ksya/ILIFERobot/images/IMG_20171003_143027.jpg

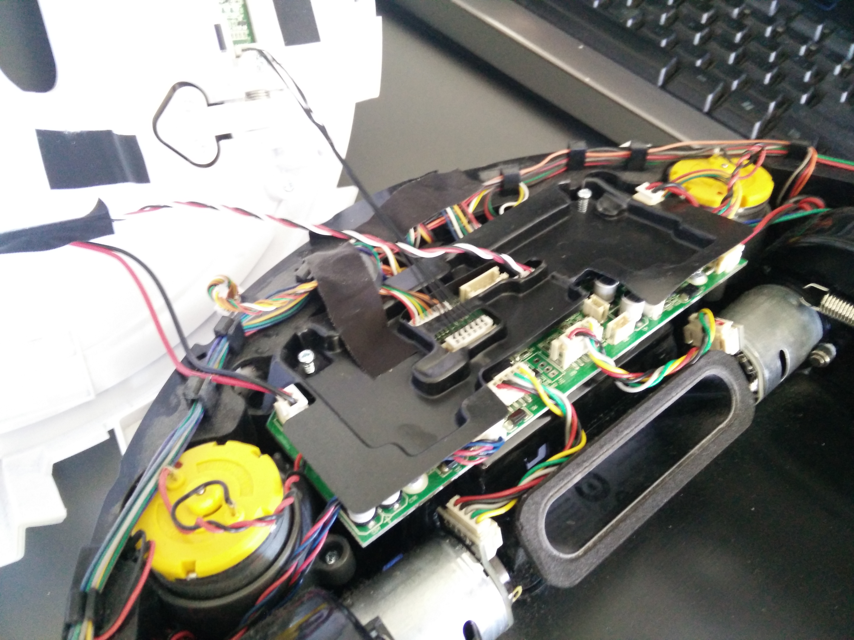
images/IMG_20171003_143027.jpg
