ksya/ILIFERobot/images/IMG_20171003_145452.jpg

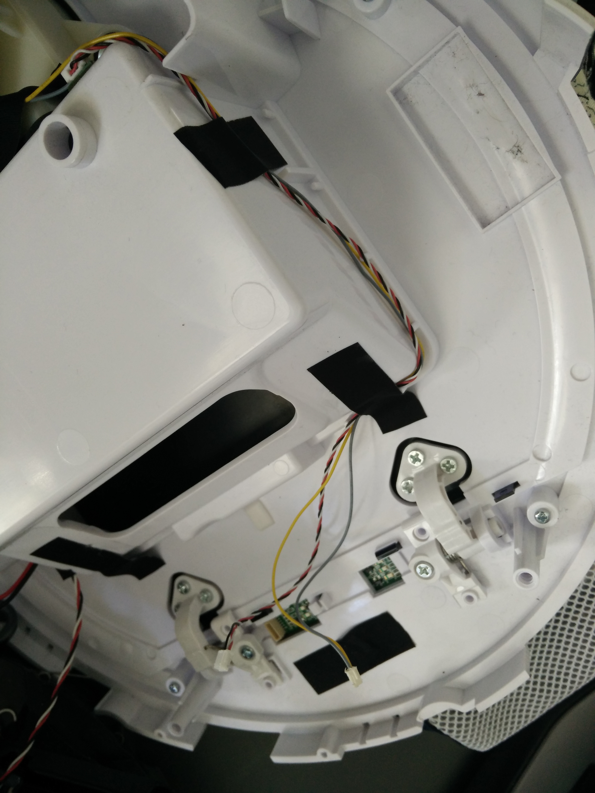
images/IMG_20171003_145452.jpg
