ksya/ILIFERobot/images/IMG_20171003_145455.jpg

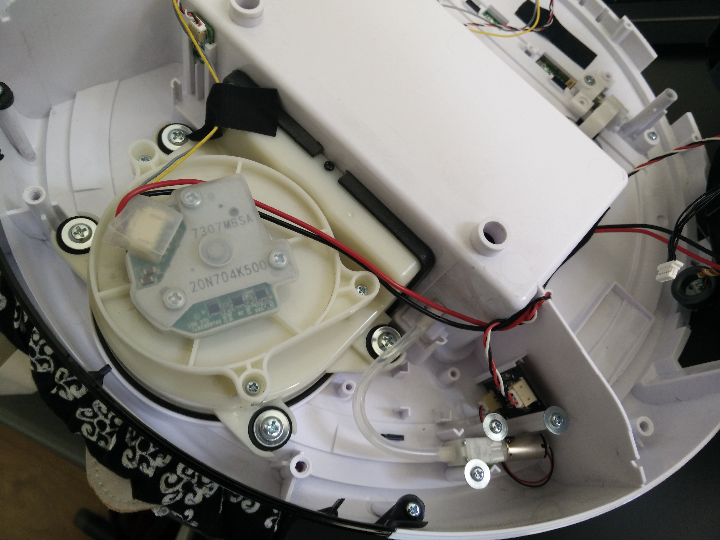
images/IMG_20171003_145455.jpg
