ksya/ILIFERobot/images/IMG_20171003_145459.jpg

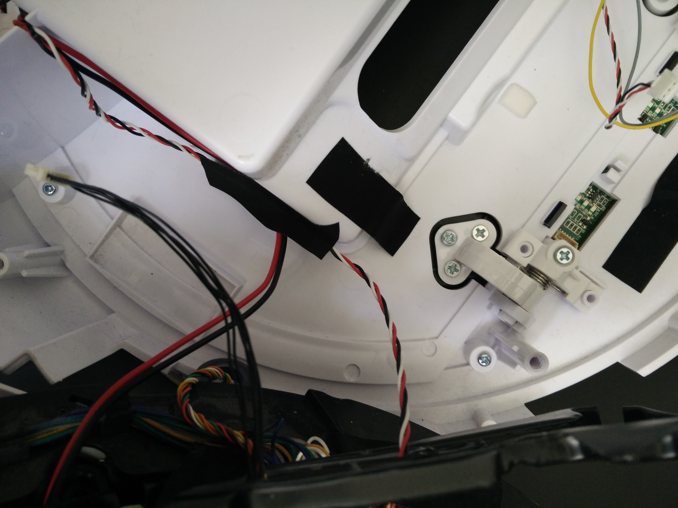
images/IMG_20171003_145459.jpg
