ksya/ILIFERobot/images/IMG_20171020_211558.jpg

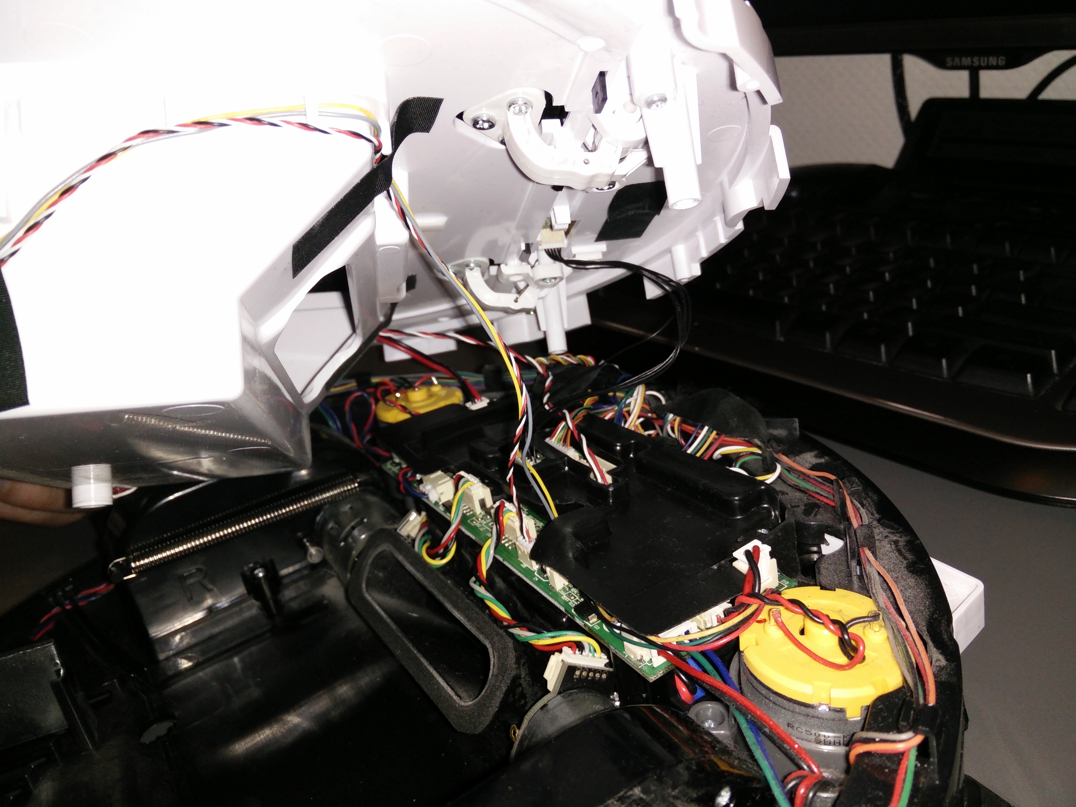
images/IMG_20171020_211558.jpg
