ksya/ILIFERobot/images/IMG_20171020_211606.jpg

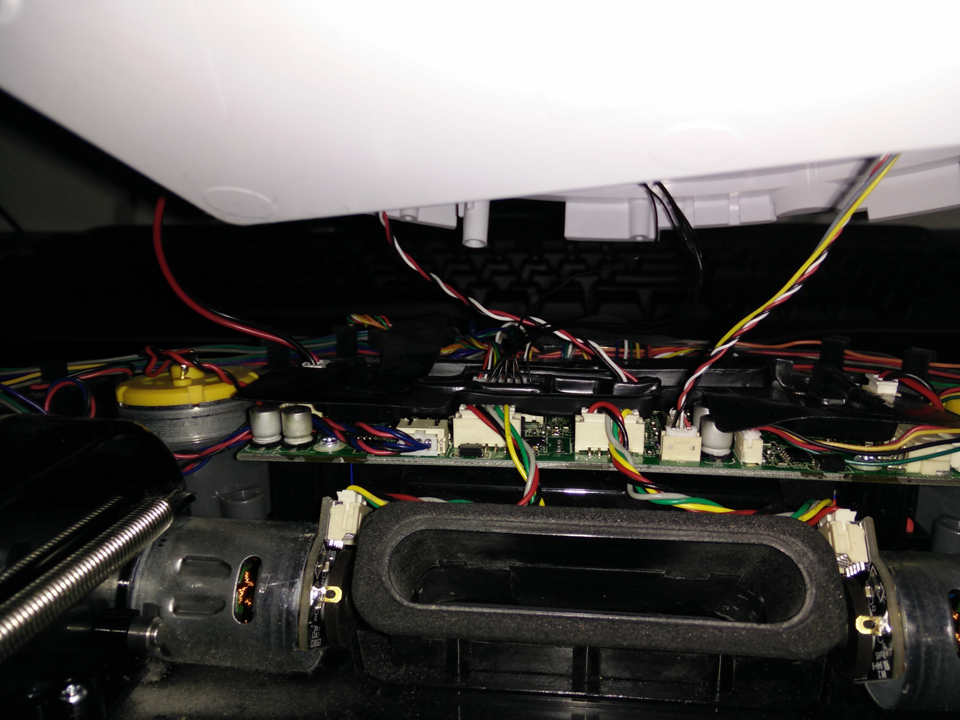
images/IMG_20171020_211606.jpg
