ksya/ILIFERobot/images/mainboard_back.jpg

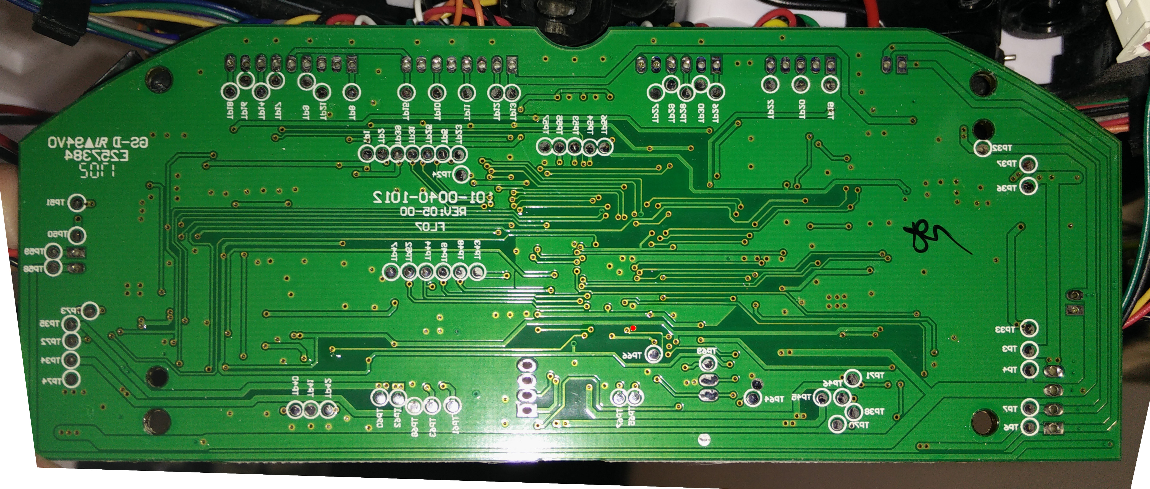
images/mainboard_back.jpg
