ksya/ILIFERobot/images/mainboard_front.jpg

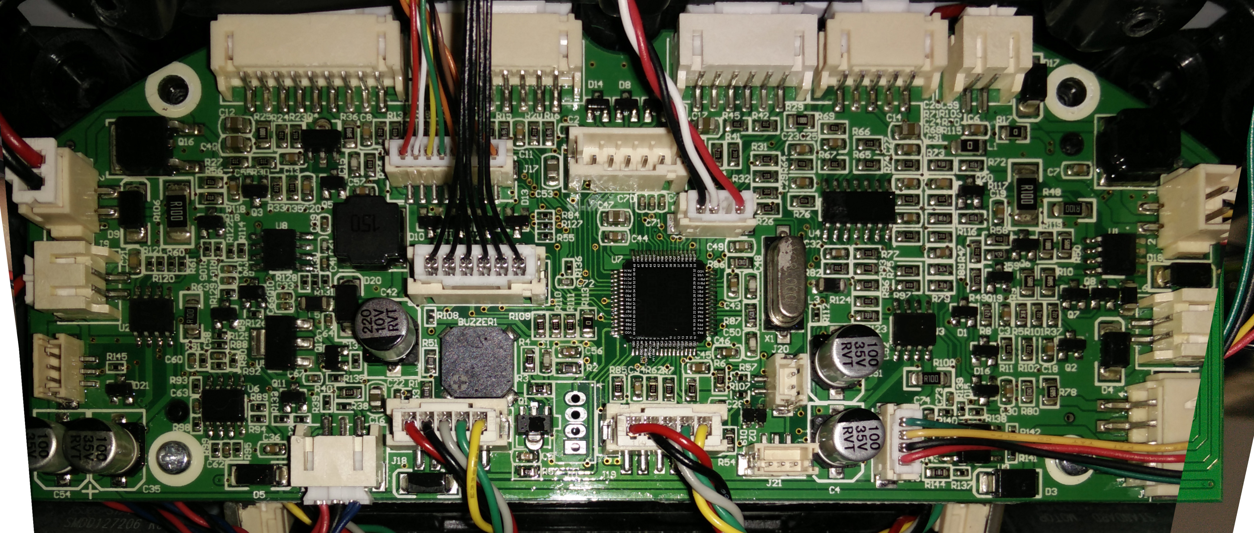
images/mainboard_front.jpg
