ksya/ILIFERobot/photos-of-installation/NodeMCU overview with strain relief.jpg

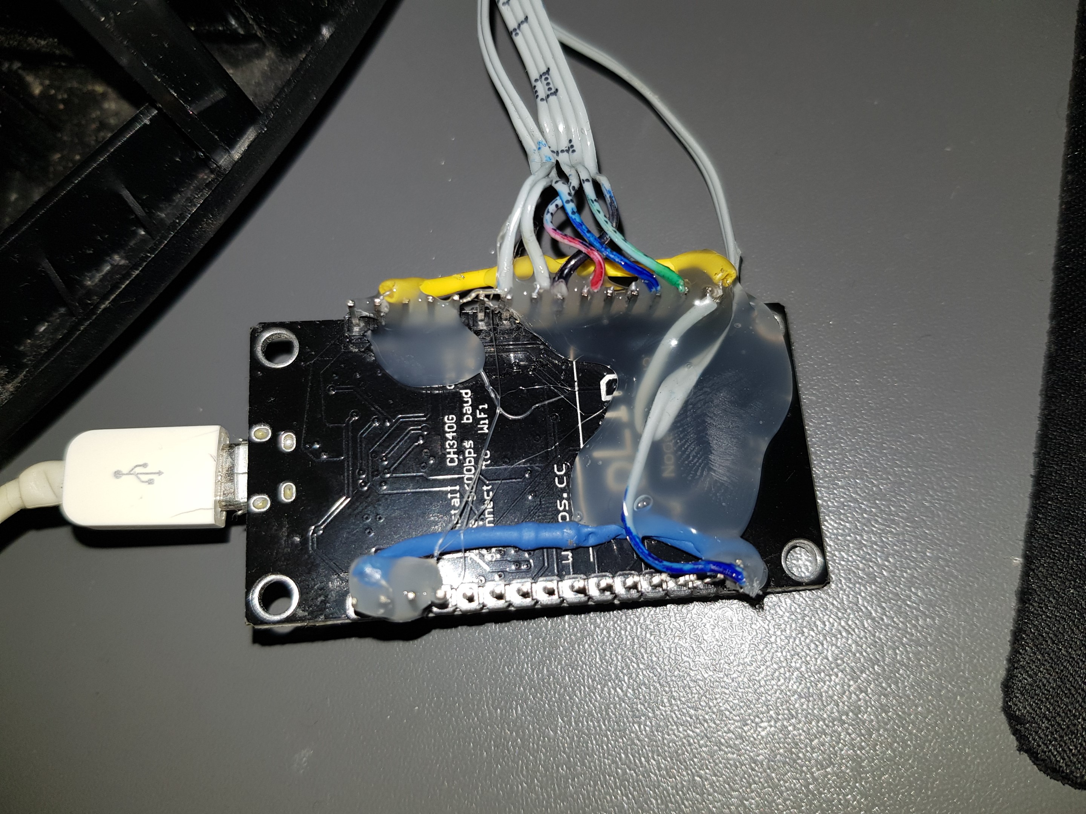
photos-of-installation/NodeMCU overview with strain relief.jpg
