ksya/ILIFERobot/photos-of-installation/PCB overview.jpg

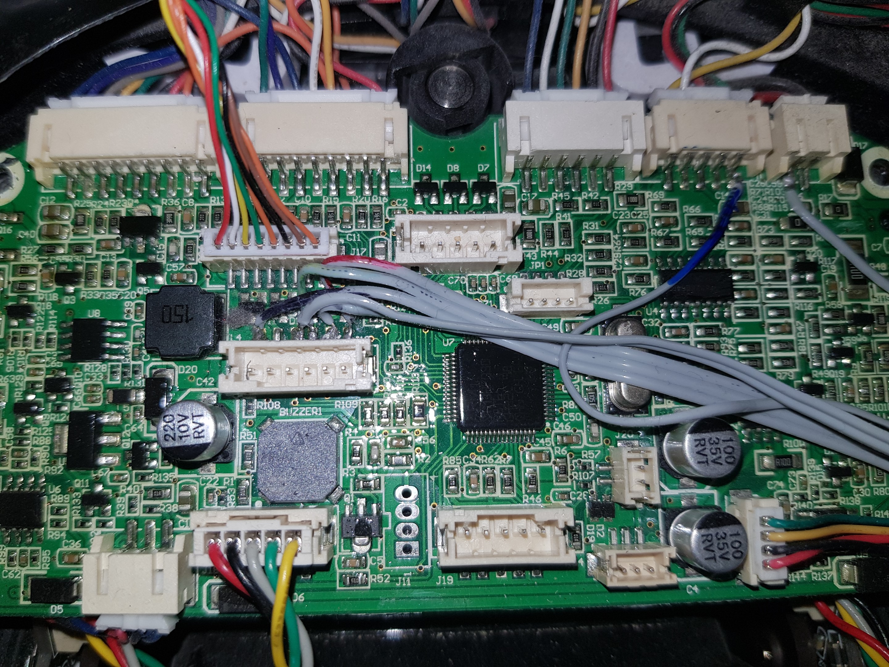
photos-of-installation/PCB overview.jpg
