ksya/ILIFERobot/photos-of-installation/Routing overview.jpg

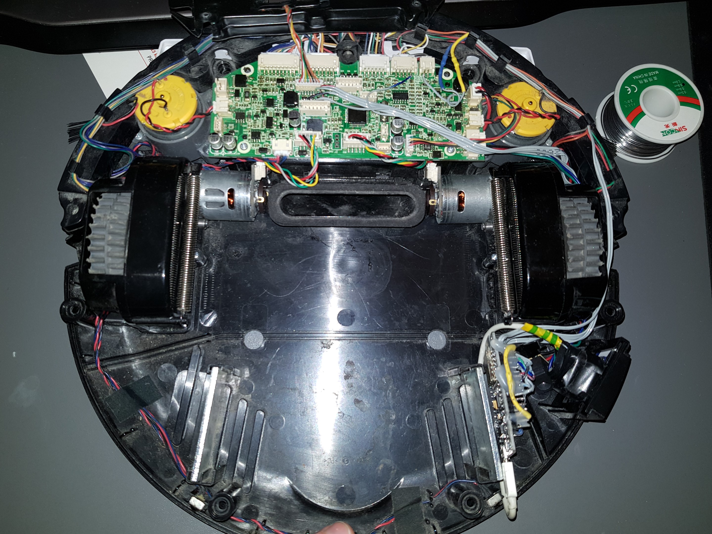
photos-of-installation/Routing overview.jpg
