ksya/ILIFERobot/photos-of-installation/External usb input 1.jpg

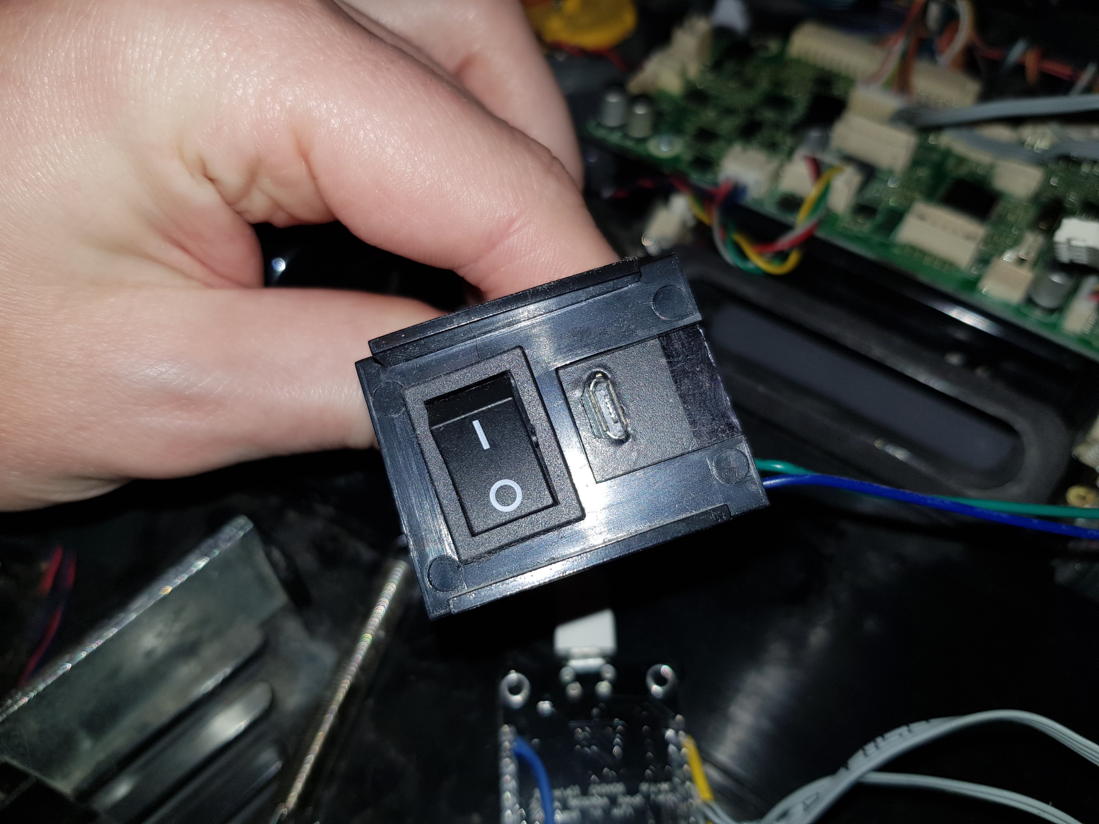
photos-of-installation/External usb input 1.jpg
