ksya/ILIFERobot/photos-of-installation/External usb input 2.jpg

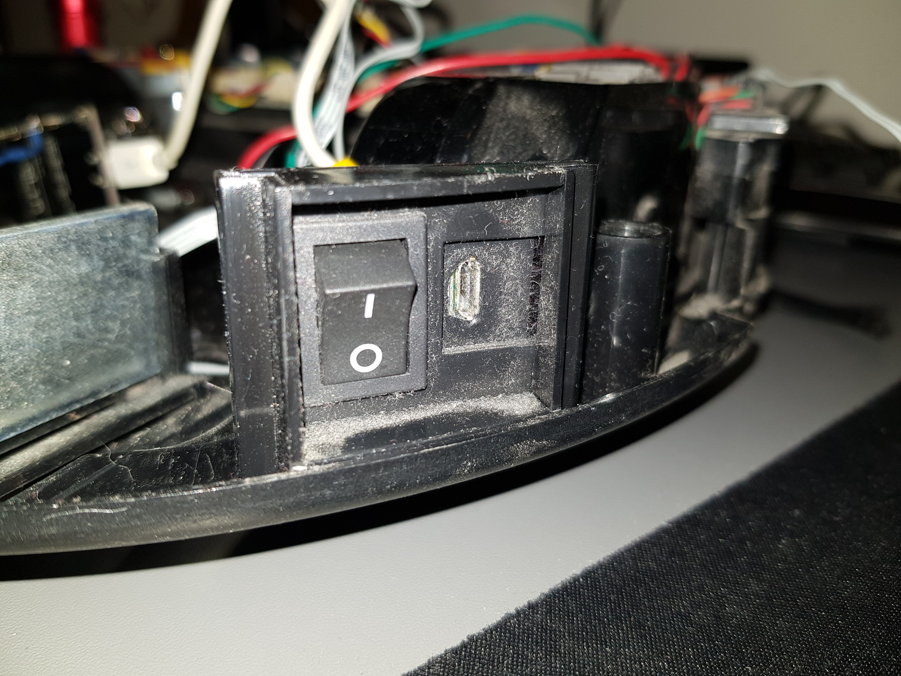
photos-of-installation/External usb input 2.jpg
