ksya/ILIFERobot/photos-of-installation/External usb input 3.jpg

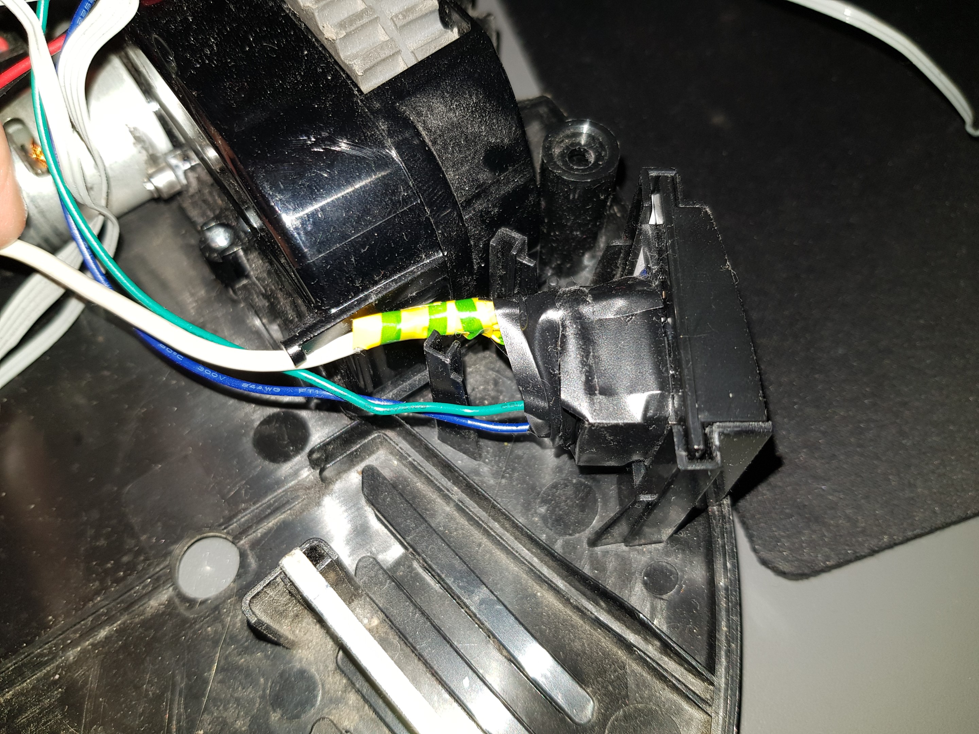
photos-of-installation/External usb input 3.jpg
