ksya/ILIFERobot/photos-of-installation/NodeMCU closeup.jpg

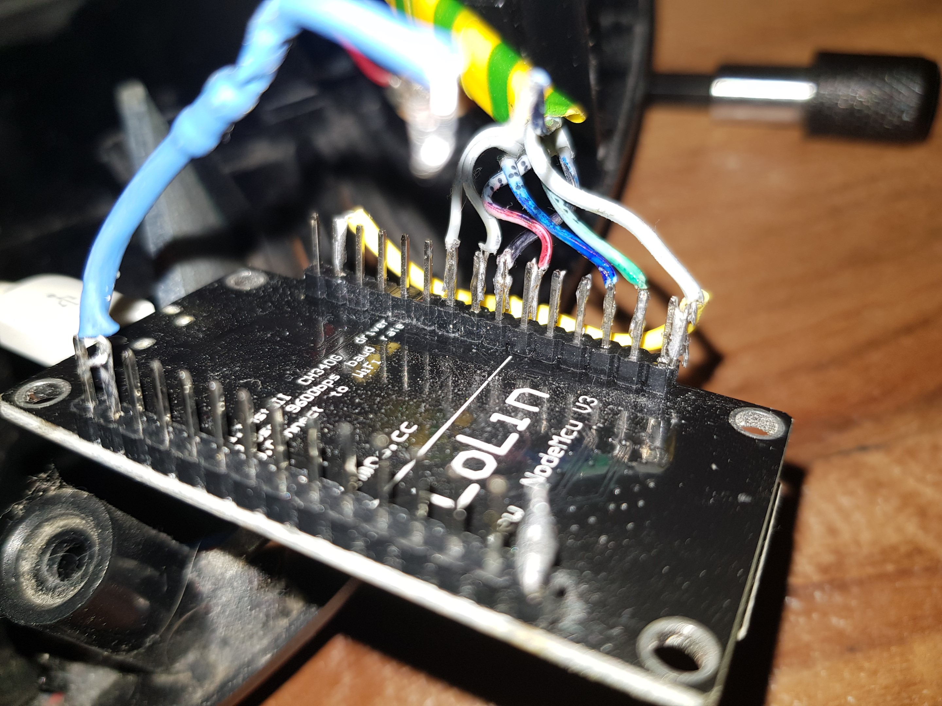
photos-of-installation/NodeMCU closeup.jpg
