ksya/ILIFERobot/photos-of-installation/NodeMCU installation 2.jpg

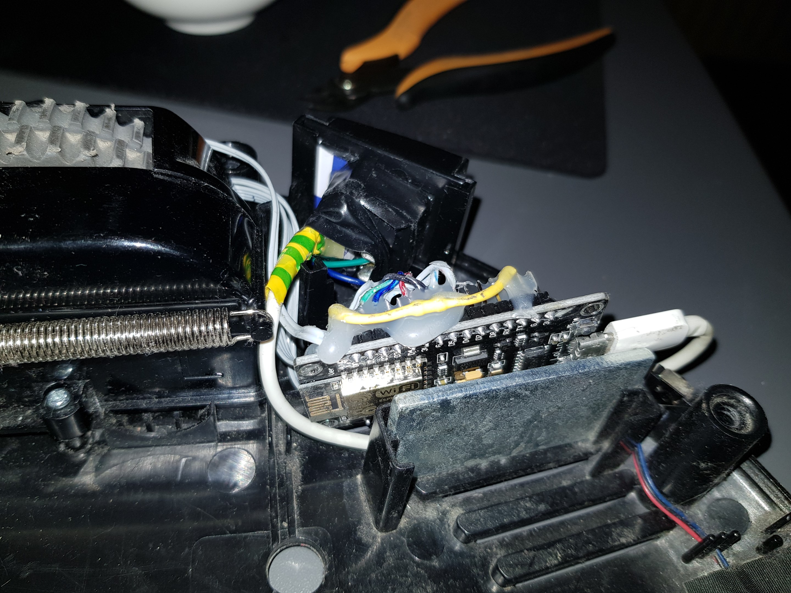
photos-of-installation/NodeMCU installation 2.jpg
