ksya/ILIFERobot/photos-of-installation/NodeMCU installation.jpg

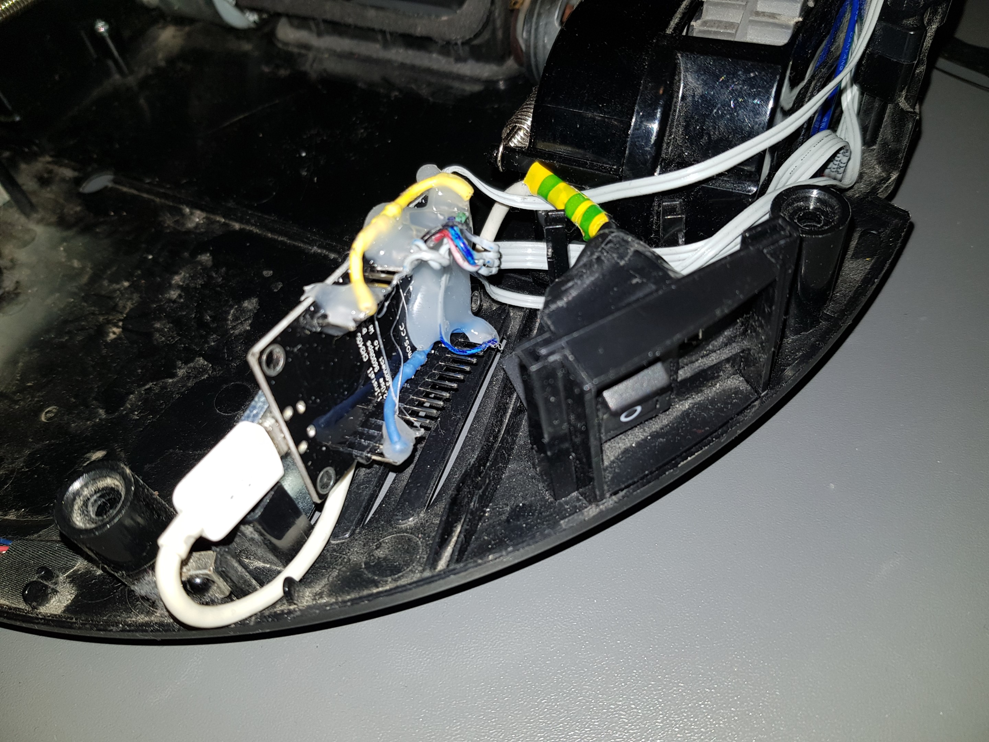
photos-of-installation/NodeMCU installation.jpg
