ksya/ILIFERobot/photos-of-installation/PCB dock IR bat closeup 2.jpg

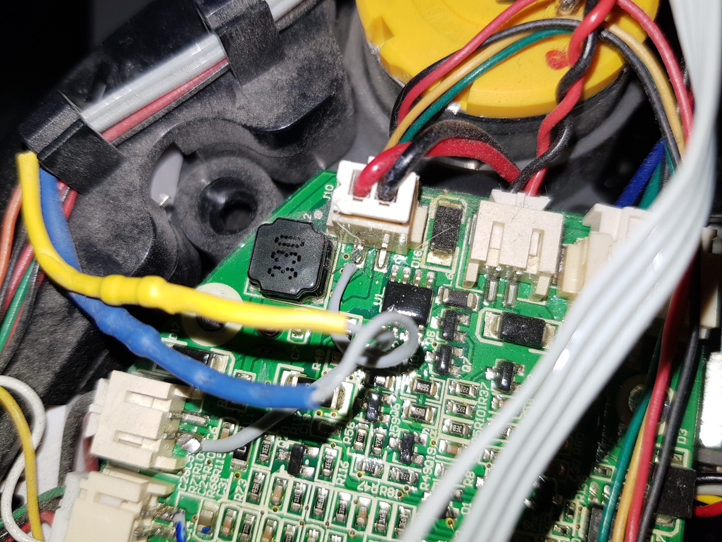
photos-of-installation/PCB dock IR bat closeup 2.jpg
