ksya/ILIFERobot/photos-of-installation/PCB dock IR bat closeup.jpg

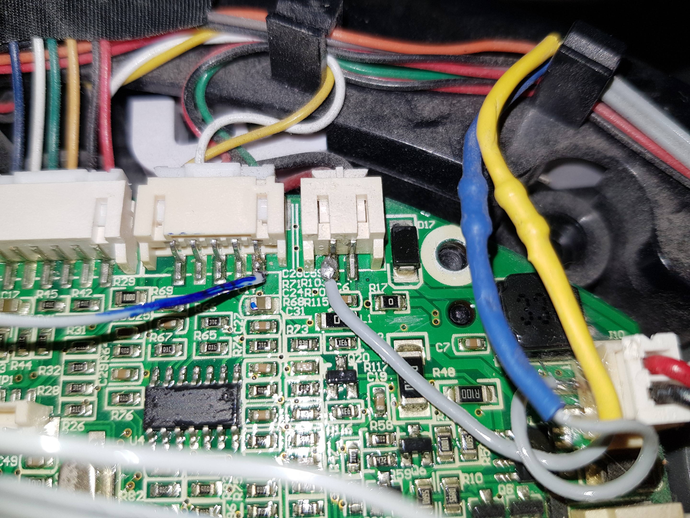
photos-of-installation/PCB dock IR bat closeup.jpg
