ksya/ILIFERobot/photos-of-installation/PCB dock IR bat.jpg

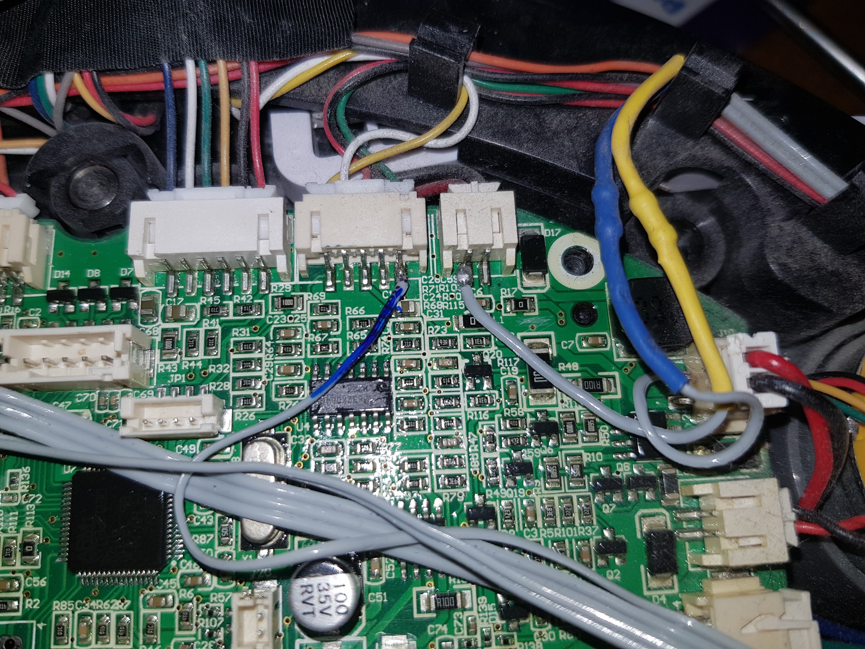
photos-of-installation/PCB dock IR bat.jpg
