ksya/ILIFERobot/(threads)

Thread 2 (2021-03-17):

Works Great

GaWr26, 2021-03-17:
Not an issue but no other way to share my appreciation!
Thanks a bunch for this. It took me little over an hour to install a wemos d1 mini and it works like a charm.
I was thinking about figuring it out myself but then found your approach even with all the status values. Great job!

Battery Voltage is a little off, but an easy fix.

Thanks again!
