ksya/ILIFERobot/(commit log)

2020-04-25 Update with more information, improved WebUI, and installation pictures
    [iliferobot.yaml]
2020-06-06 fix web bug, improve time sync
    [getTime.ino, http.ino, mqtt.ino]
